SenpaiSimon/automotive-multipurpose-led-controller/README.md

# Multipurpose Controller for Cars multimedia

Functions present on the board: 

- 5 LED Controller Ports for WS2811
- Controllable Subwoofer Audio Singal Damper
- Switch to toggle Subwoofer Amplifier on and off
- Bluetooth Module to Control
- Atmega Microcontroller with UART Bridge
- Direct Voltage input from car battery
