SenpaiSimon/automotive-multipurpose-led-controller/4d3b9066e6c082feba06c4ad93f8758ed9aa3db6_2_1000x1000.png

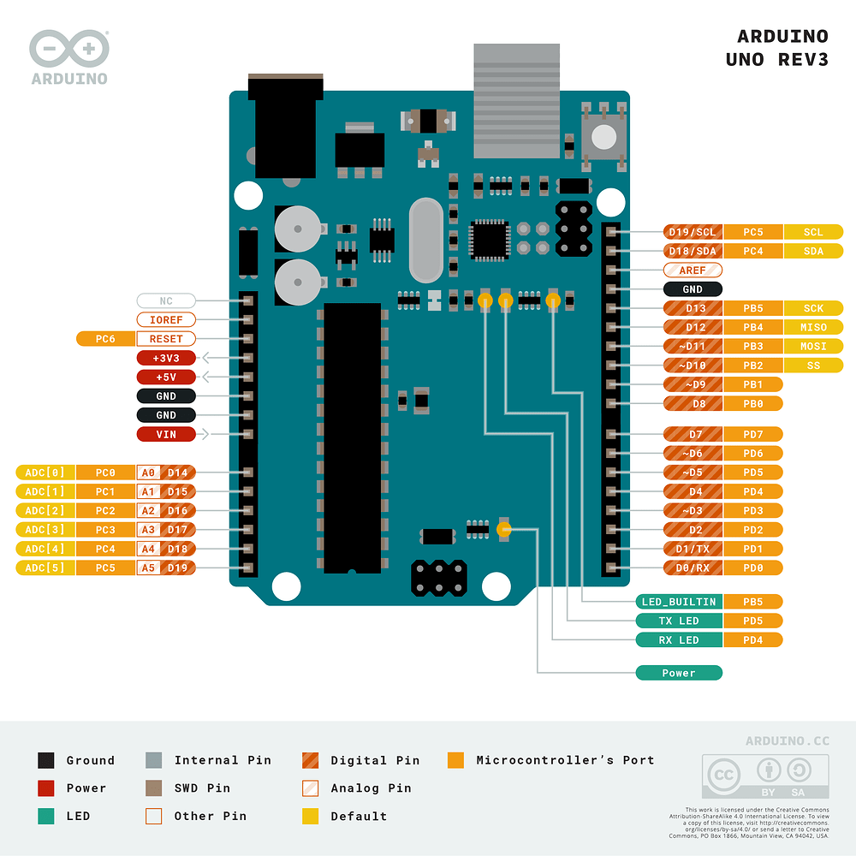
4d3b9066e6c082feba06c4ad93f8758ed9aa3db6_2_1000x1000.png
