SenpaiSimon/automotive-multipurpose-led-controller/CarLED_Atmega28/Car LEDs.kicad_pcb

## KiCad design CarLED_Atmega28/Car LEDs.kicad_pcb (2022-05-12)

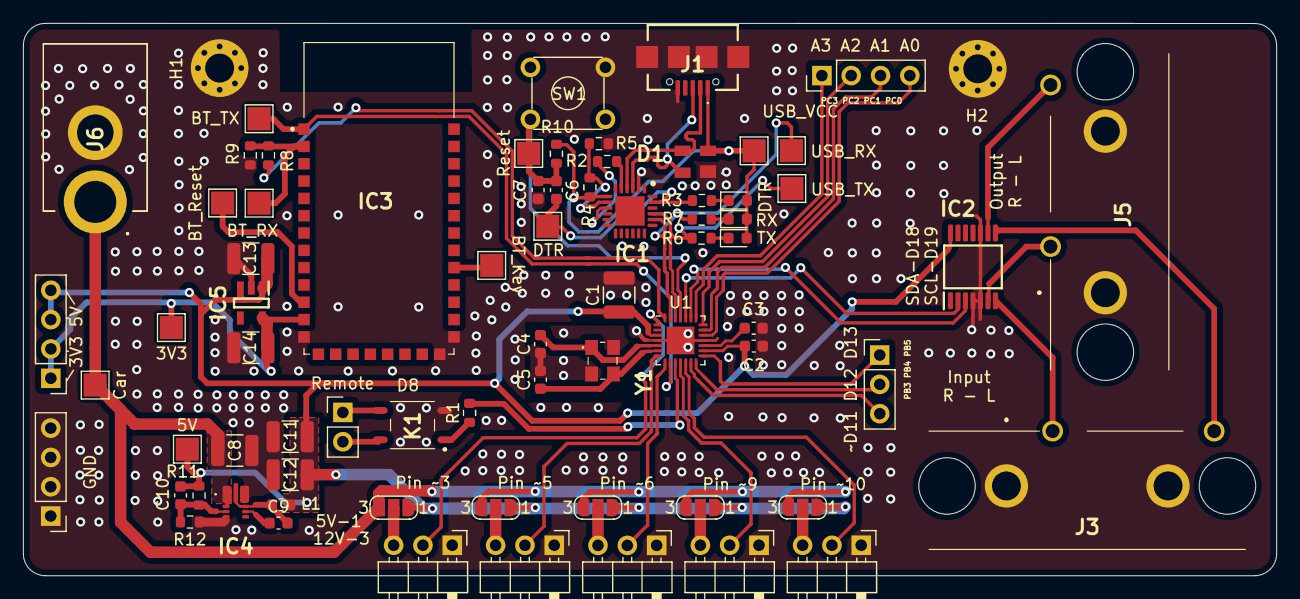
[picture p2: board Car LEDs.kicad_pcb from above]

Board: 2 copper layers, 108.6 x 47.9 mm, 73 parts (0 on the bottom side), 55 nets.

Parts:
C1, C8: 10u; C_1210_3225Metric
C2, C3, C6, C7, C9: 100n; C_0603_1608Metric
C4, C5: 8p; C_0603_1608Metric
C10: 47p; C_0603_1608Metric
C11, C12: 22u; C_1210_3225Metric
C13, C14: 1u; C_1210_3225Metric
D1: SP0503BAHTG
DTR: RED; LED_0603_1608Metric
H1, H2: MountingHole_Pad; MountingHole_2.5mm_Pad_Via
IC1: CP2102N-A02-GQFN24R; QFN50P400X400X80-25N-D
IC2: MCP4631-502E_ST; SOP65P640X120-14N
IC3: BLUETOOTH-SERIAL-HC-06; BLUETOOTHSERIALHC06
IC4: AP63356DV-7; AP63356DV7
IC5: AP7343DQ-33W5-7; SOT95P285X140-5N
J1: USB_B_Micro; UJ2MIBHGSMTTR
J2: Remote; PinHeader_1x02_P2.54mm_Vertical
J3: Input; RCJ2121
J4: IO; PinHeader_1x04_P2.54mm_Vertical
J5: Output; RCJ2121
J6: CAR_Jack; PJ037A
J7: LED1_Pin3; PinHeader_1x03_P2.54mm_Horizontal
J8: LED2_Pin5; PinHeader_1x03_P2.54mm_Horizontal
J9: LED3_Pin6; PinHeader_1x03_P2.54mm_Horizontal
J10: LED4_Pin9; PinHeader_1x03_P2.54mm_Horizontal
J11: LED5_Pin10; PinHeader_1x03_P2.54mm_Horizontal
J12: IO2; PinHeader_1x03_P2.54mm_Vertical
J13: Power; PinHeader_1x04_P2.54mm_Vertical
J14: GND; PinHeader_1x04_P2.54mm_Vertical
JP1, JP2, JP3, JP4, JP5: VCC; SolderJumper-3_P1.3mm_Open_RoundedPad1.0x1.5mm_NumberLabels
K1: CPC1125NTR
L1: 6.8u; L_0603_1608Metric
R1: 750; R_0603_1608Metric
R2, R8: 1k; R_0603_1608Metric
R3, R6, R7: 220; R_0603_1608Metric
R4: 22.1k; R_0603_1608Metric
R5: 47.5k; R_0603_1608Metric
R9: 2k; R_0603_1608Metric
R10: 10k; R_0603_1608Metric
R11: 157k; R_0603_1608Metric
R12: 30k; R_0603_1608Metric
RX: GREEN; LED_0603_1608Metric
SW1: SW_Push; Button_Omron
TP2: RX; TestPoint_Pad_2.0x2.0mm
TP3: TX; TestPoint_Pad_2.0x2.0mm
TP4: USBVCC; TestPoint_Pad_2.0x2.0mm
TP5: DTR; TestPoint_Pad_2.0x2.0mm
TP6: Jack; TestPoint_Pad_2.0x2.0mm
TP7: Reset; TestPoint_Pad_2.0x2.0mm
TP8: BT_Key; TestPoint_Pad_2.0x2.0mm
TP9: BT_Reset; TestPoint_Pad_2.0x2.0mm
TP10: 5V; TestPoint_Pad_2.0x2.0mm
TP11: 3V3; TestPoint_Pad_2.0x2.0mm
TP12: BT_TX; TestPoint_Pad_2.0x2.0mm
TP13: BT_RX; TestPoint_Pad_2.0x2.0mm
TX: GREEN; LED_0603_1608Metric
U1: ATmega328-MMH; QFN-28-1EP_4x4mm_P0.45mm_EP2.4x2.4mm
Y1: ECS-160-9-33B-CKM-TR; ECS2501033BCKMTR

Connections:
3V3: C14.1, IC3.12, IC5.5, J13.1, J13.2, TP11.1
5V: C1.1, C2.1, C10.1, C11.1, C12.1, C13.1, IC2.14, IC5.1, IC5.3, J13.3, J13.4, JP1.1, JP2.1, JP3.1, JP4.1, JP5.1, L1.2, R11.1, TP10.1, U1.3, U1.16
BT_RX: IC3.2, R8.2, R9.1, TP13.1
BT_TX: IC3.1, TP12.1, U1.9
CAR_Power: C8.1, IC4.1, IC4.2, J6.1, JP1.3, JP2.3, JP3.3, JP4.3, JP5.3, TP6.1
D+: D1.4, IC1.3, J1.3
D-: D1.3, IC1.4, J1.2
DTR: C6.2, IC1.23, R3.2, TP5.1
Data1: J7.2, U1.1
Data2: J8.2, U1.7
Data3: J9.2, U1.8
Data4: J10.2, U1.11
Data5: J11.2, U1.12
GND: C1.2, C2.2, C3.2, C4.1, C5.2, C7.2, C8.2, C11.2, C12.2, C13.2, C14.2, D1.1, H1.1, H2.1, IC1.2, IC2.4, IC2.5, IC2.10, IC3.13, IC3.21, IC3.22, IC4.4, IC4.8, IC5.2, J1.5, J1.6, J3.1, J3.3, J5.1, J5.3, J6.2, J7.1, J8.1, J9.1, J10.1, J11.1, J14.1, J14.2, J14.3, J14.4, K1.2, R5.2, R9.2, R12.2, SW1.2, U1.4, U1.18, U1.29, Y1.2, Y1.4
L_IN: IC2.8, J3.4
L_OUT: IC2.9, J5.4
unnamed: C3.1, U1.17
unnamed: C4.2, U1.5, Y1.1
unnamed: C5.1, U1.6, Y1.3
unnamed: C9.1, IC4.6
unnamed: C9.2, IC4.9, L1.1
unnamed: C10.2, IC4.3, R11.2, R12.1
unnamed: DTR.1, R3.1
unnamed: R6.2, TX.1
unnamed: R7.2, RX.1
unnamed: IC1.5, R2.1
unnamed: IC1.8, R4.2, R5.1
unnamed: IC1.9, R2.2
unnamed: IC3.11, TP9.1
unnamed: IC3.26, TP8.1
unnamed: J2.1, K1.3
unnamed: J2.2, K1.4
unnamed: J4.1, U1.22
unnamed: J4.2, U1.21
unnamed: J4.3, U1.20
unnamed: J4.4, U1.19
unnamed: J7.3, JP1.2
unnamed: J8.3, JP2.2
unnamed: J9.3, JP3.2
unnamed: J10.3, JP4.2
unnamed: J11.3, JP5.2
unnamed: J12.1, U1.15
unnamed: J12.2, U1.14
unnamed: J12.3, U1.13
unnamed: K1.1, R1.1
unnamed: R8.1, U1.28
R_IN: IC2.7, J3.2
R_OUT: IC2.6, J5.2
RemoteON: R1.2, U1.10
Reset: C6.1, C7.1, R10.2, SW1.1, TP7.1, U1.25
SCL: IC2.2, U1.24
SDA: IC2.3, U1.23
USB_RX: IC1.20, R7.1, TP2.1, U1.27
USB_TX: IC1.21, R6.1, TP3.1, U1.26
USB_VCC: D1.2, DTR.2, IC1.7, J1.1, R4.1, R10.1, RX.2, TP4.1, TX.2
