SenpaiSimon/automotive-multipurpose-led-controller/(commit log)

2022-04-07 inititial commit
    [Car LEDs-B_Cu.gbr, Car LEDs-B_Mask.gbr, Car LEDs-B_Paste.gbr, Car LEDs-B_SilkS.gbr, Car LEDs-Edge_Cuts.gbr, Car LEDs-F_Cu.gbr, Car LEDs-F_Mask.gbr, Car LEDs-F_Paste.gbr]
2022-05-12 bumped kicad version
    [Car LEDs.kicad_pcb, Car LEDs.kicad_sch]
